bionicbone/Gasser_Monitor_v1/Documentation/Temperature Tx Telemetry Setup.jpg

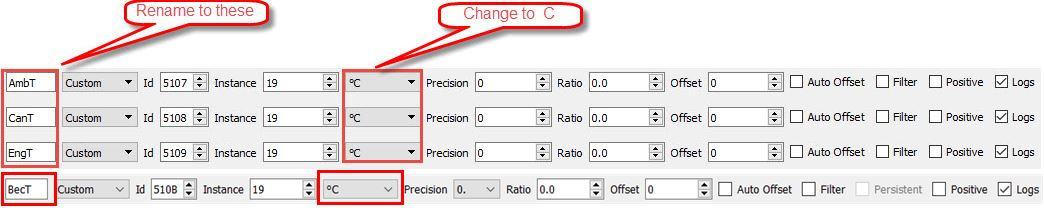
Documentation/Temperature Tx Telemetry Setup.jpg
