bionicbone/Gasser_Monitor_v1/Documentation/Cheep 5v BEC.jpg

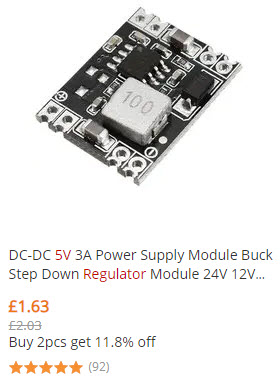
Documentation/Cheep 5v BEC.jpg
