bionicbone/Gasser_Monitor_v1/Documentation/LQ BFP Methodology.jpg

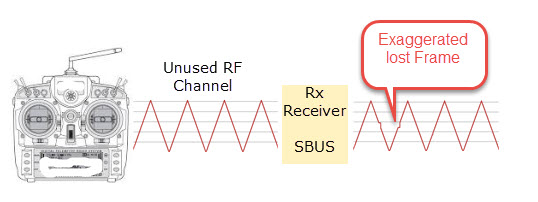
Documentation/LQ BFP Methodology.jpg
