bionicbone/Gasser_Monitor_v1/Documentation/LQ Hold 16ch 2 Wave Calculation on ch1-8.jpg

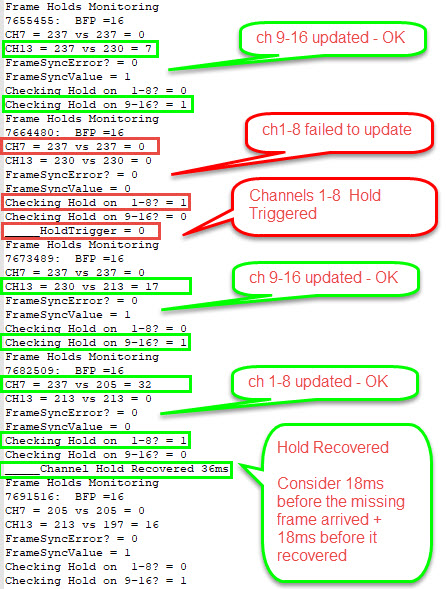
Documentation/LQ Hold 16ch 2 Wave Calculation on ch1-8.jpg
