bionicbone/Gasser_Monitor_v1/Documentation/LQ Hold 16ch 2 Wave Chart.jpg

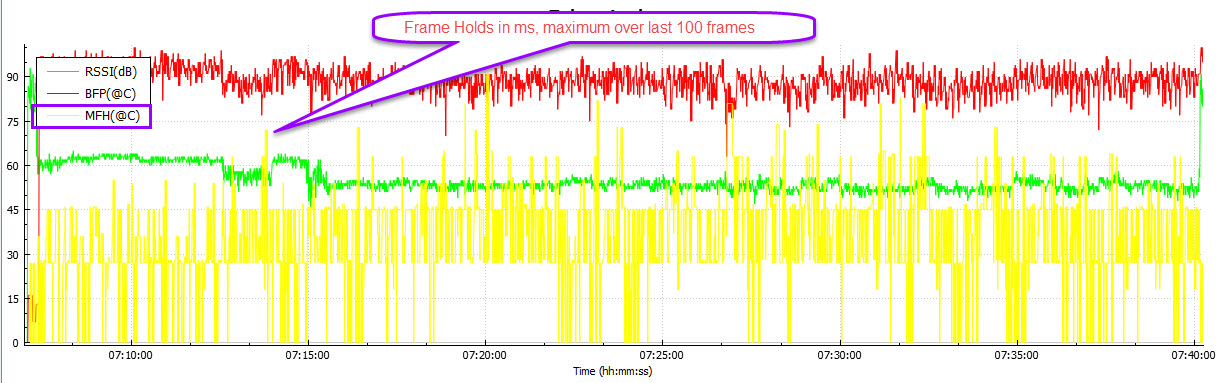
Documentation/LQ Hold 16ch 2 Wave Chart.jpg
