bionicbone/Gasser_Monitor_v1/Documentation/LQ LFP on v2.1.0 firmware.jpg

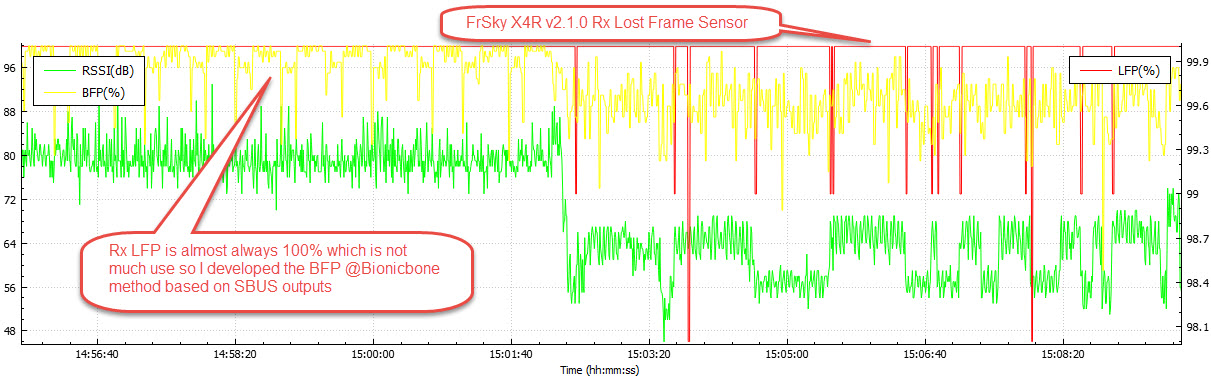
Documentation/LQ LFP on v2.1.0 firmware.jpg
