bionicbone/Gasser_Monitor_v1/Documentation/LQ Sync16ch 2 Wave Success.jpg

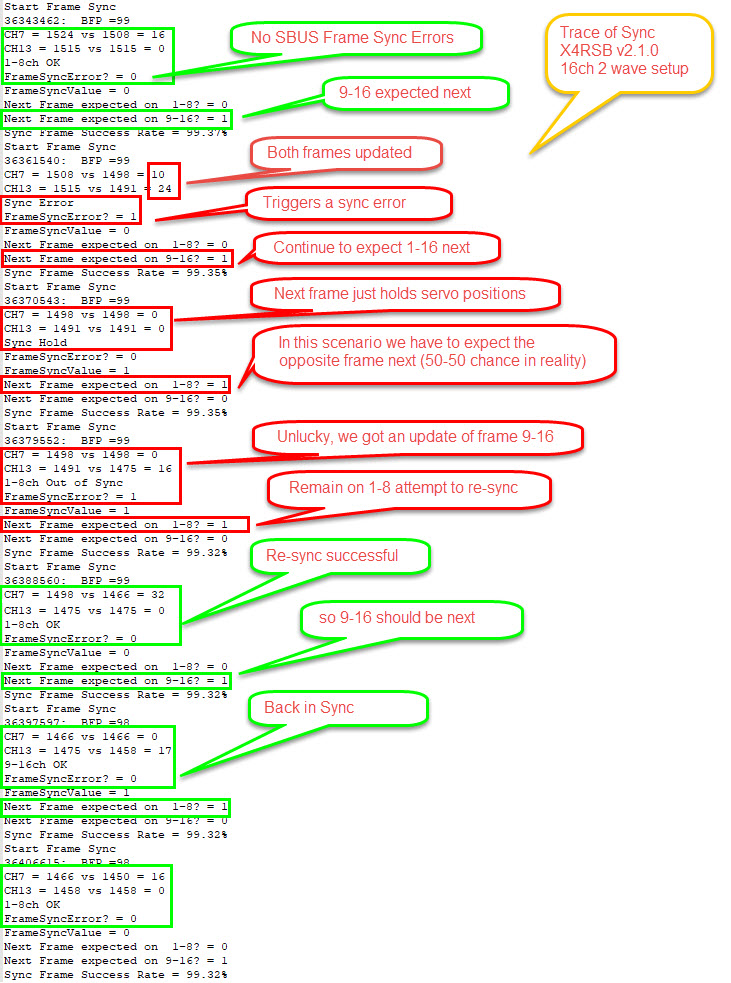
Documentation/LQ Sync16ch 2 Wave Success.jpg
