bionicbone/Gasser_Monitor_v1/Documentation/OLED Flight Battery Voltage.jpg

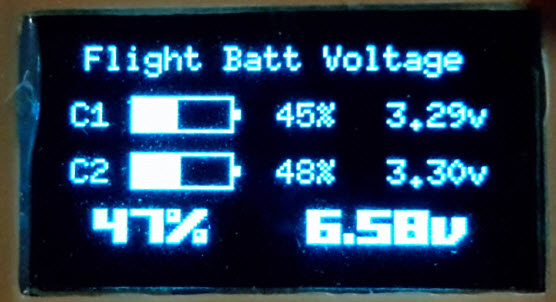
Documentation/OLED Flight Battery Voltage.jpg
