bionicbone/Gasser_Monitor_v1/Documentation/Power Charging Circuit.jpg

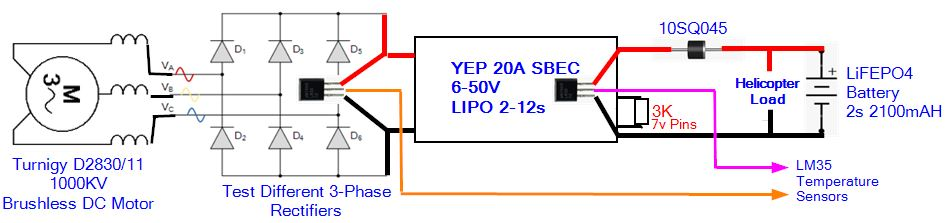
Documentation/Power Charging Circuit.jpg
