bionicbone/Gasser_Monitor_v1/Documentation/Power Modules.jpg

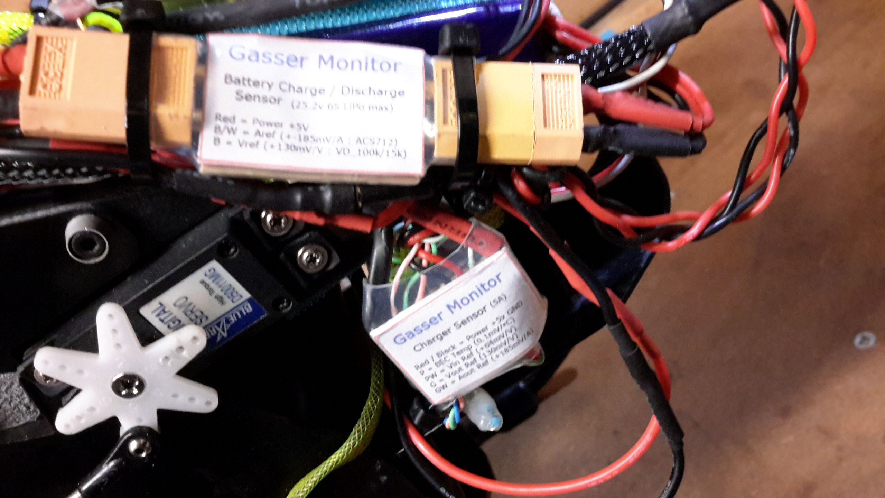
Documentation/Power Modules.jpg
