bionicbone/Gasser_Monitor_v1/Documentation/Power Rectifier Pic 1.jpg

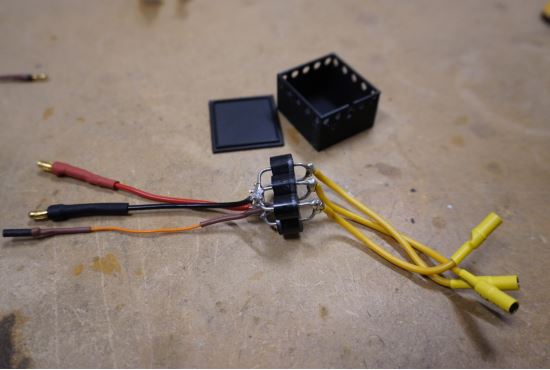
Documentation/Power Rectifier Pic 1.jpg
