bionicbone/Gasser_Monitor_v1/Documentation/Power Rectifier Pic 2.jpg

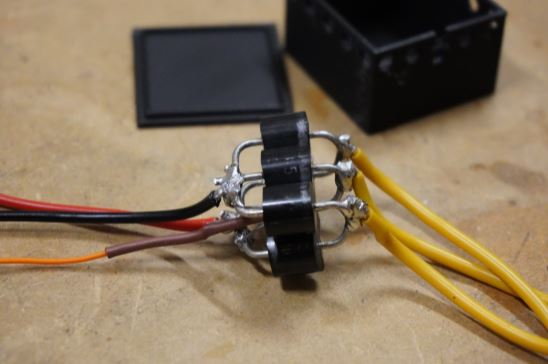
Documentation/Power Rectifier Pic 2.jpg
