bionicbone/Gasser_Monitor_v1/Documentation/Power Rectifier Pic 3.jpg

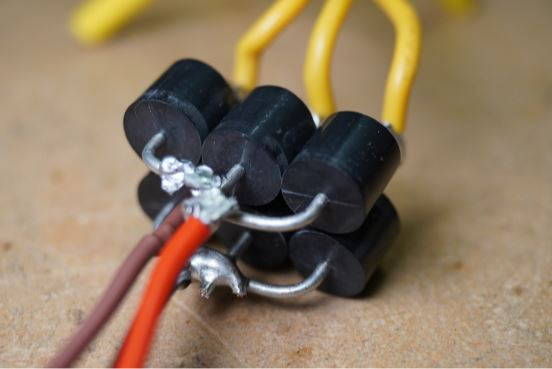
Documentation/Power Rectifier Pic 3.jpg
