bionicbone/Gasser_Monitor_v1/Documentation/Power Rectifier Pic 4.jpg

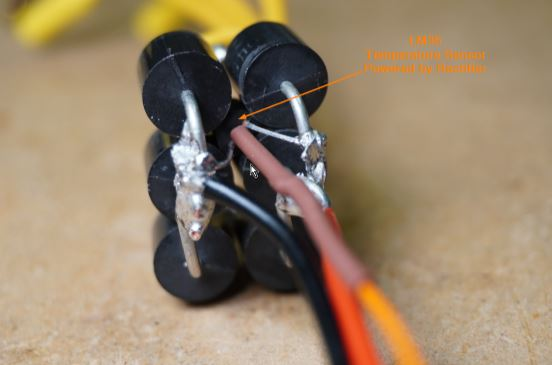
Documentation/Power Rectifier Pic 4.jpg
