bionicbone/Gasser_Monitor_v1/Documentation/Power Rectifier Pic 5.jpg

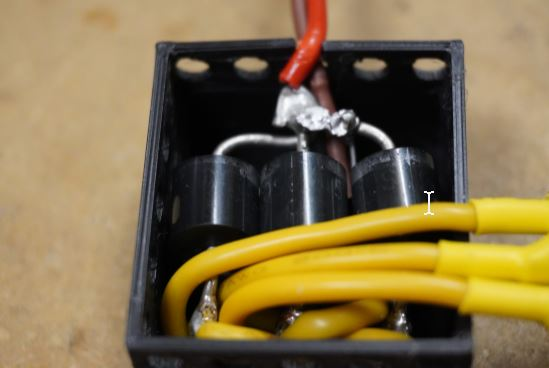
Documentation/Power Rectifier Pic 5.jpg
