bionicbone/Gasser_Monitor_v1/Documentation/Power Sensors Analysis.jpg

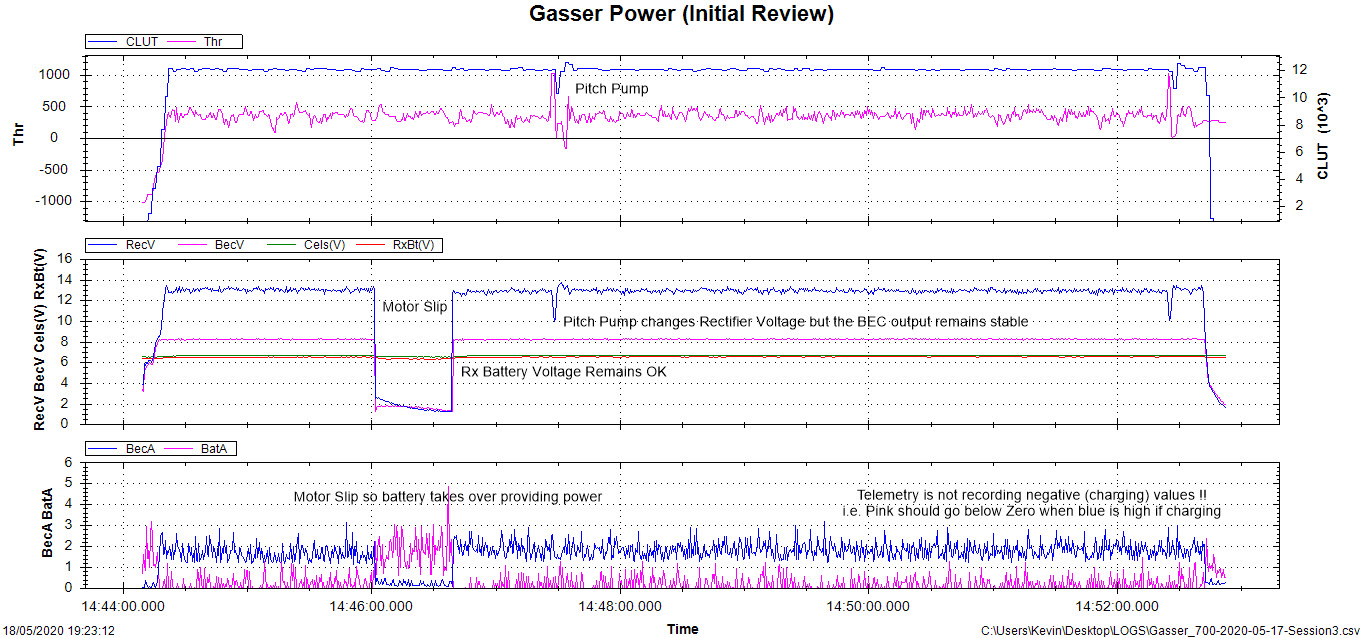
Documentation/Power Sensors Analysis.jpg
