bionicbone/Gasser_Monitor_v1/Documentation/RPM Charging Dog Sensor.jpg

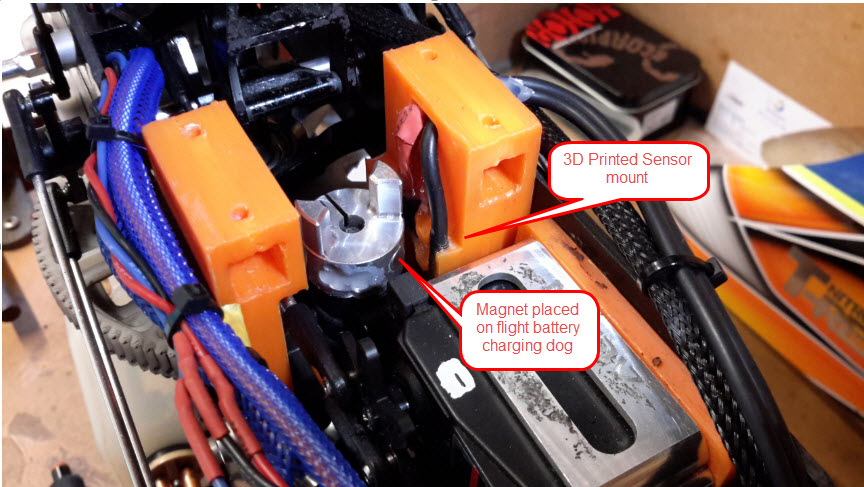
Documentation/RPM Charging Dog Sensor.jpg
