bionicbone/Gasser_Monitor_v1/Documentation/RPM Clutch Analysis.jpg

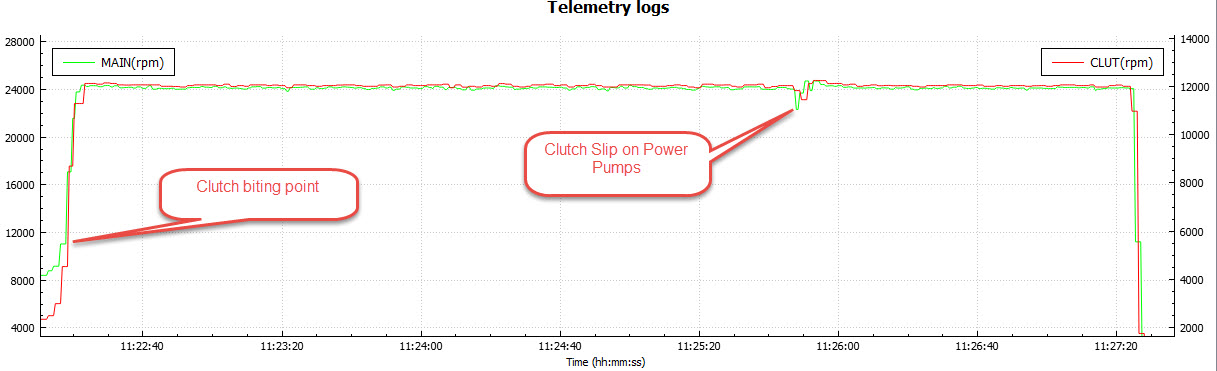
Documentation/RPM Clutch Analysis.jpg
