bionicbone/Gasser_Monitor_v1/Documentation/RPM Clutch Sensor.jpg

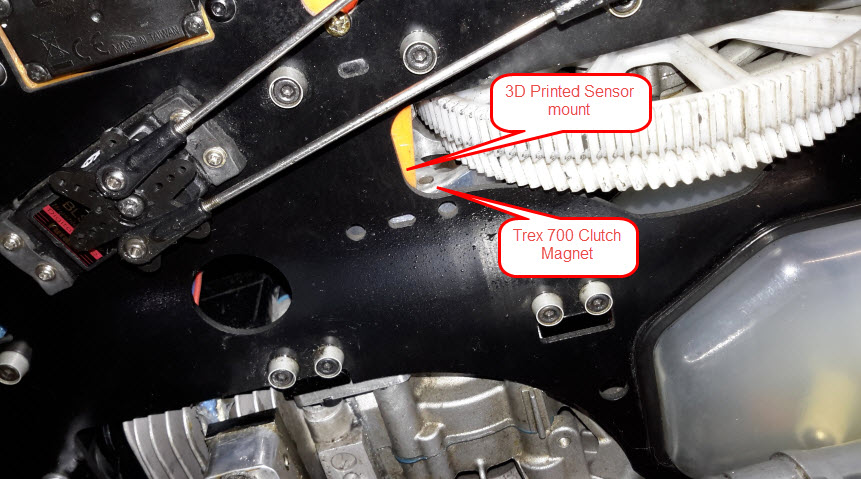
Documentation/RPM Clutch Sensor.jpg
