bionicbone/Gasser_Monitor_v1/Documentation/RPM Sensor Connections.jpg

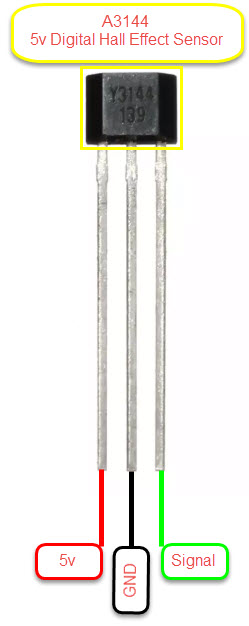
Documentation/RPM Sensor Connections.jpg
