bionicbone/Gasser_Monitor_v1/Documentation/RPM Sensor Fitting with Magnets.jpg

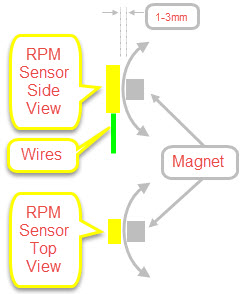
Documentation/RPM Sensor Fitting with Magnets.jpg
