bionicbone/Gasser_Monitor_v1/Documentation/SD BFP MCHM Chart.jpg

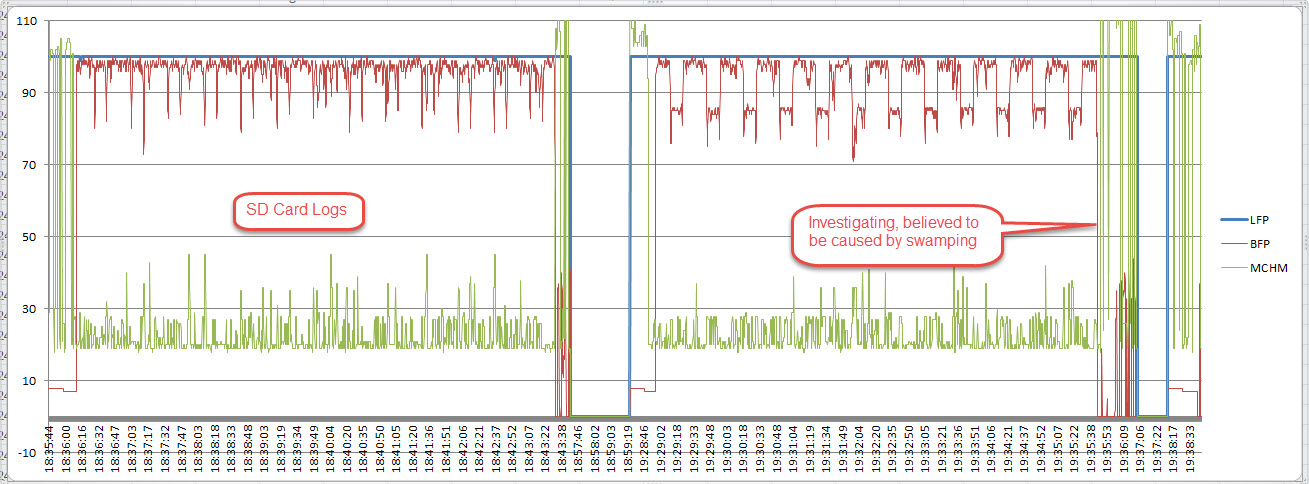
Documentation/SD BFP MCHM Chart.jpg
