bionicbone/Gasser_Monitor_v1/Documentation/SD Connection Picture.jpg

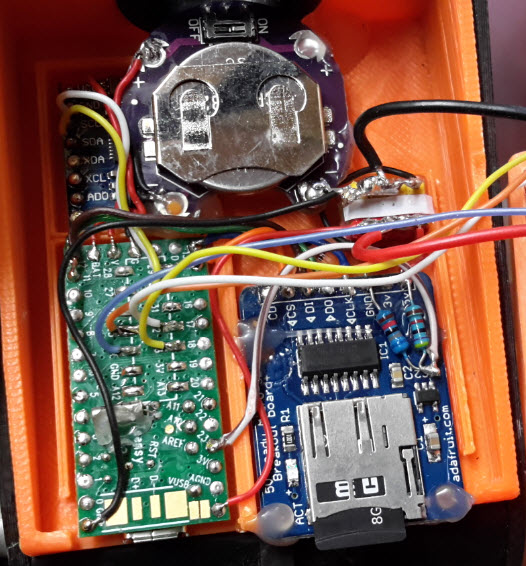
Documentation/SD Connection Picture.jpg
