bionicbone/Gasser_Monitor_v1/Documentation/SD Connections.jpg

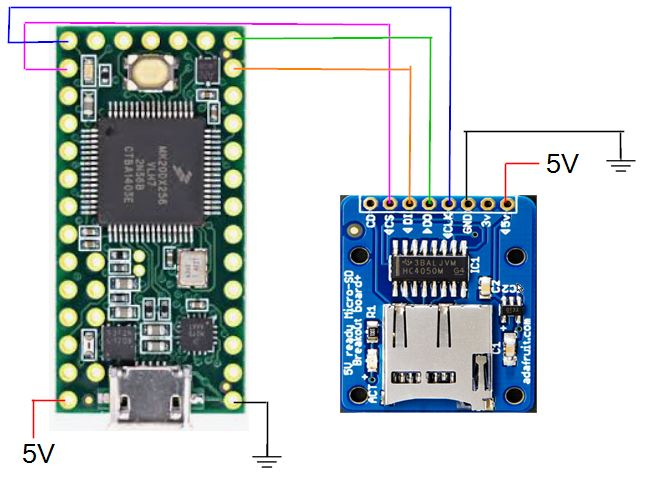
Documentation/SD Connections.jpg
