bionicbone/Gasser_Monitor_v1/Documentation/Sticker Battery Charge Discharge.jpg

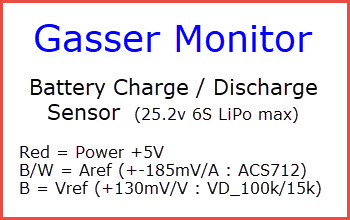
Documentation/Sticker Battery Charge Discharge.jpg
