bionicbone/Gasser_Monitor_v1/Documentation/Sticker BEC Charger Sensor.jpg

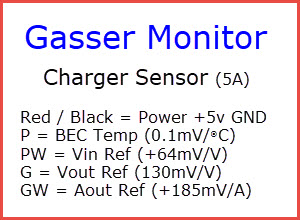
Documentation/Sticker BEC Charger Sensor.jpg
