bionicbone/Gasser_Monitor_v1/Documentation/Teensy FLVSS MLVSS connections.jpg

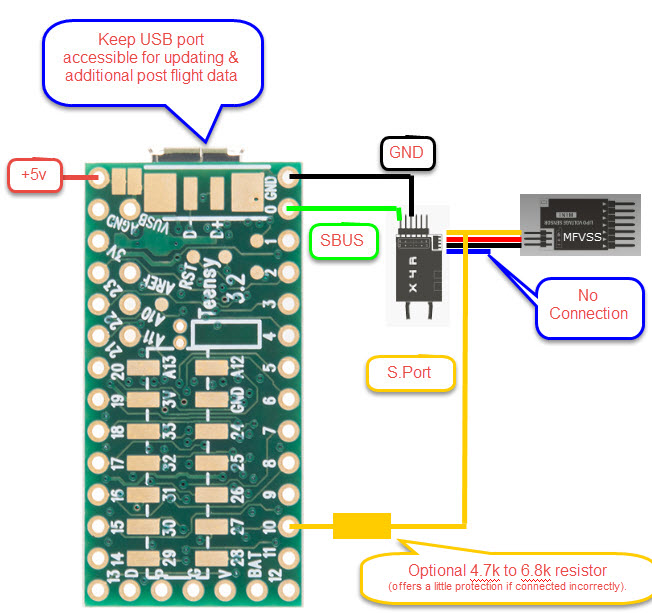
Documentation/Teensy FLVSS MLVSS connections.jpg
