bionicbone/Gasser_Monitor_v1/Documentation/Teensy LM35 Temperature Connections.jpg

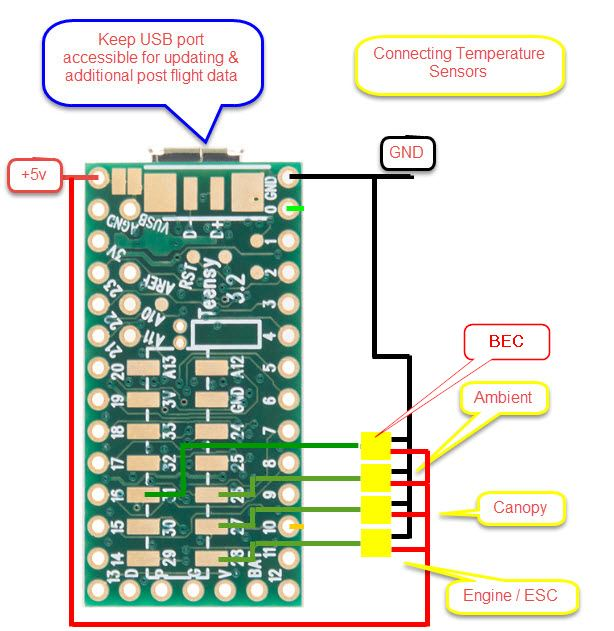
Documentation/Teensy LM35 Temperature Connections.jpg
