bionicbone/Gasser_Monitor_v1/Documentation/Teensy Power Cut Track.jpg

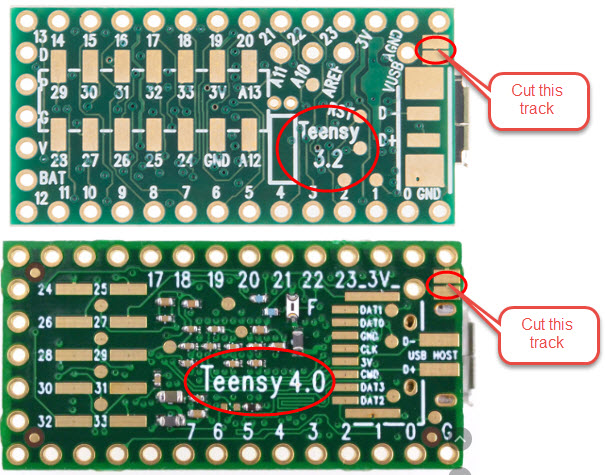
Documentation/Teensy Power Cut Track.jpg
