bionicbone/Gasser_Monitor_v1/Documentation/Teensy Power SBUS SPORT connections.jpg

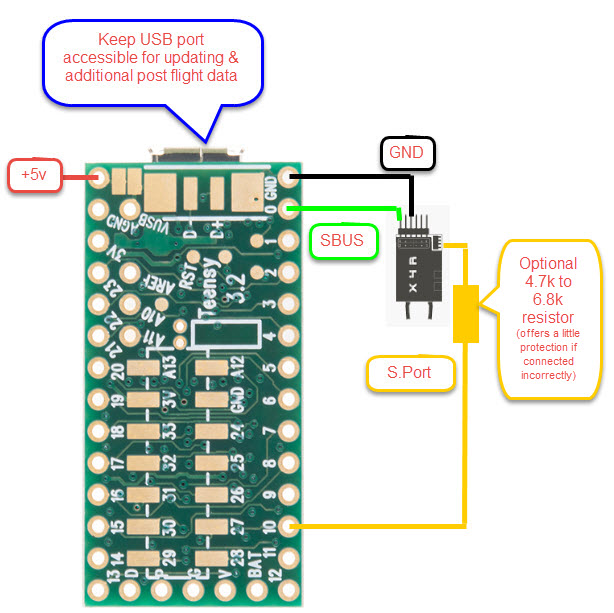
Documentation/Teensy Power SBUS SPORT connections.jpg
