bionicbone/Gasser_Monitor_v1/Documentation/Teensy RPM Connections.jpg

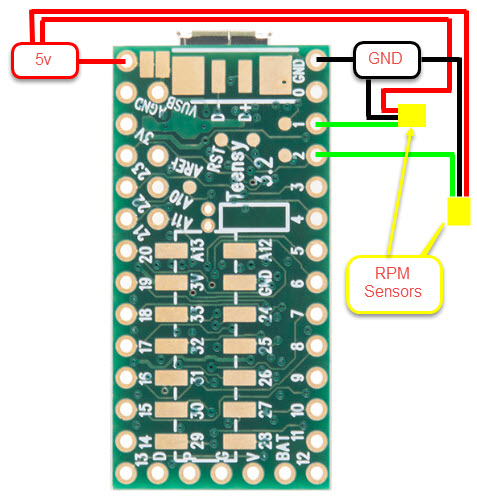
Documentation/Teensy RPM Connections.jpg
