bionicbone/Gasser_Monitor_v1/Documentation/Temperature BEC with Canopy On.jpg

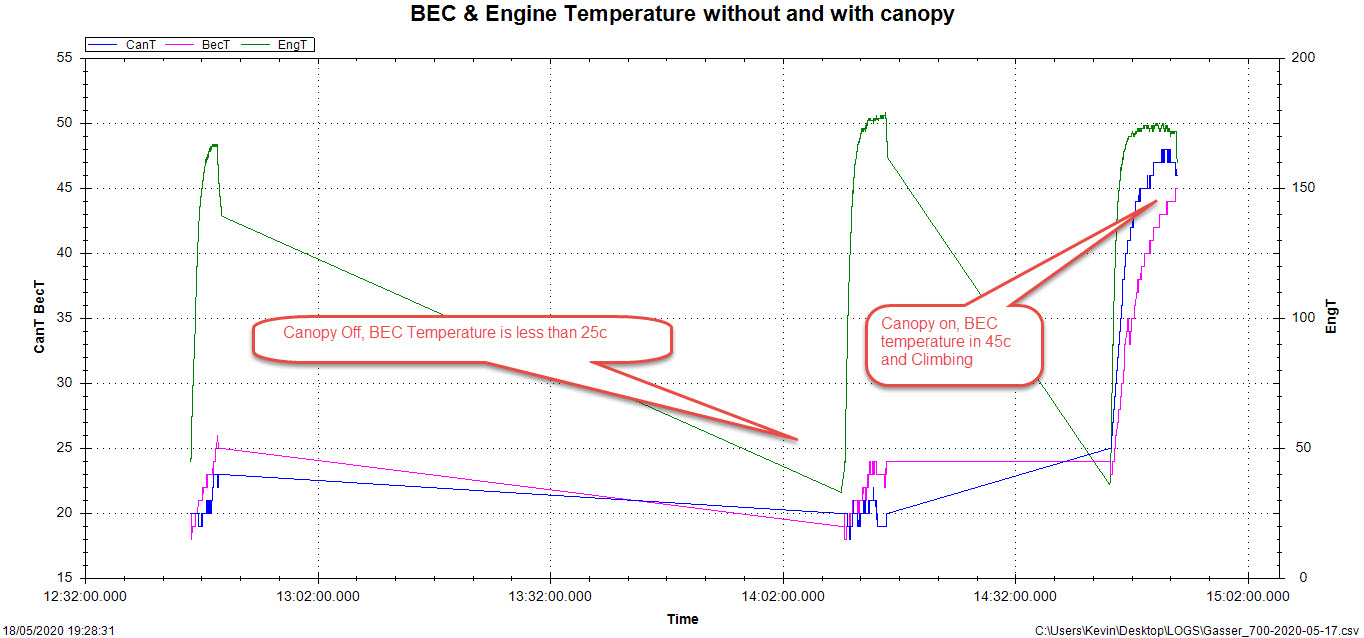
Documentation/Temperature BEC with Canopy On.jpg
