bionicbone/Gasser_Monitor_v1/Documentation/Temperature Engine LM35 Sensor Placement.jpg

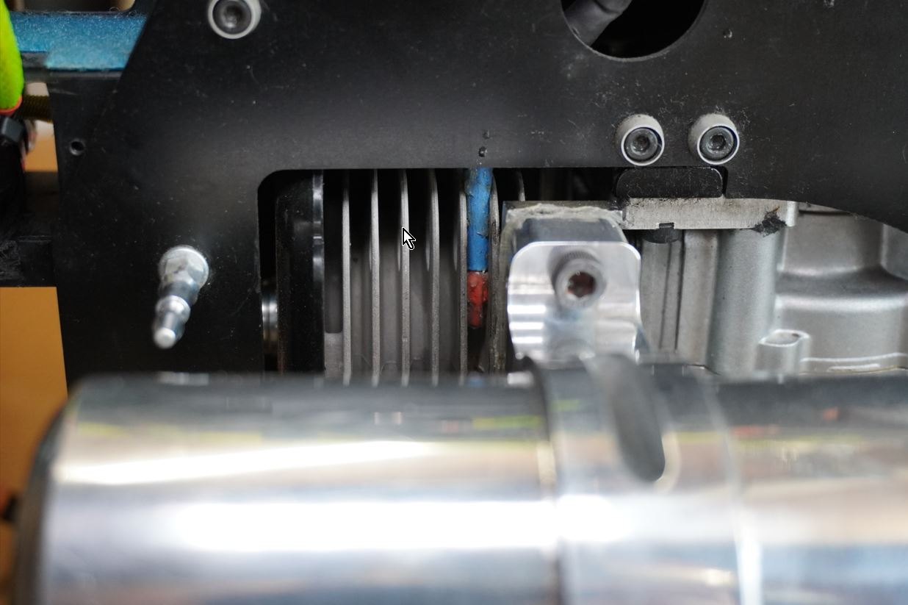
Documentation/Temperature Engine LM35 Sensor Placement.jpg
