bionicbone/Gasser_Monitor_v1/Documentation/Temperature Sensor Analysis.jpg

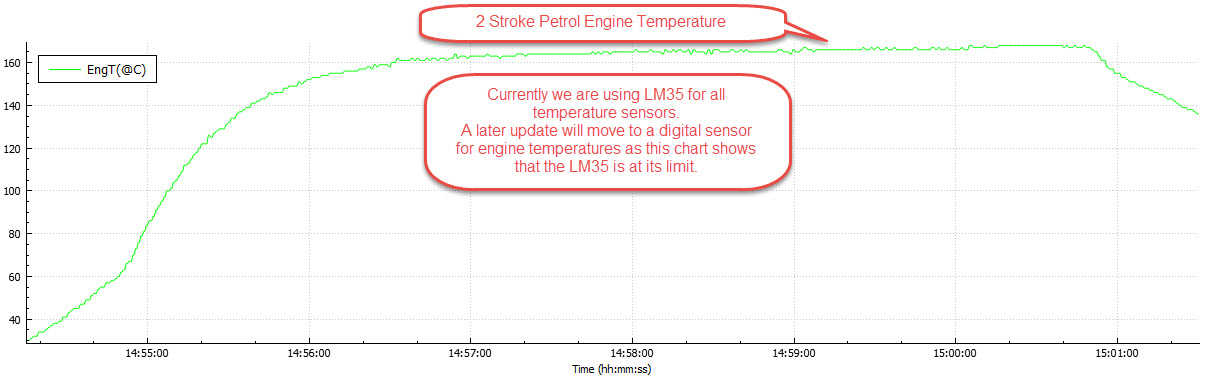
Documentation/Temperature Sensor Analysis.jpg
