bionicbone/Gasser_Monitor_v1/Documentation/Temperature Sensor Connections.jpg

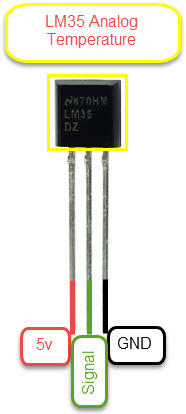
Documentation/Temperature Sensor Connections.jpg
