bionicbone/Gasser_Monitor_v1/Documentation/LQ Tx Wave Setup Channel Check.jpg

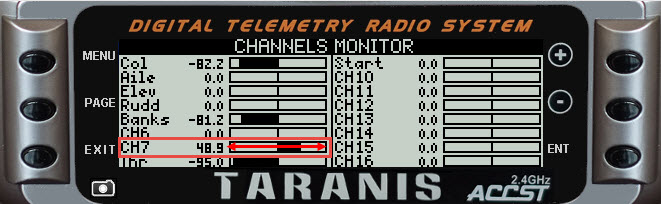
Documentation/LQ Tx Wave Setup Channel Check.jpg
