bionicbone/Gasser_Monitor_v1/Documentation/LQ Tx Wave Setup Mix Copy.jpg

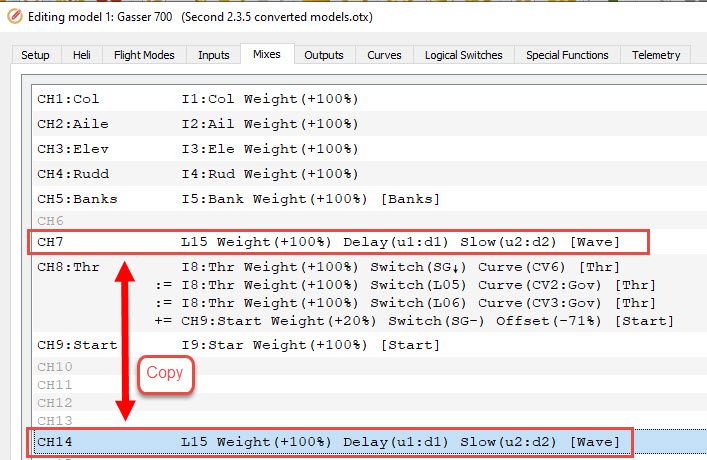
Documentation/LQ Tx Wave Setup Mix Copy.jpg
