bionicbone/Gasser_Monitor_v1/Documentation/OLED Wiring Picture.jpg

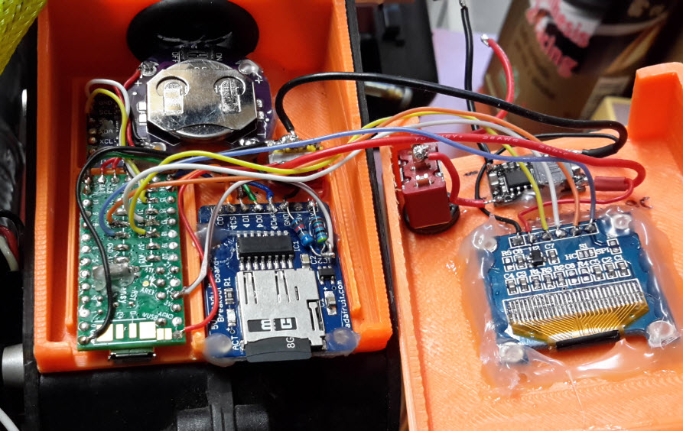
Documentation/OLED Wiring Picture.jpg
