bionicbone/Gasser_Monitor_v1/Documentation/OLED Wiring.jpg

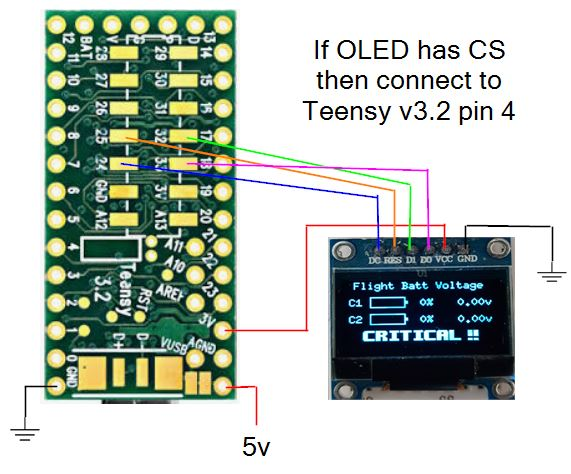
Documentation/OLED Wiring.jpg
