bionicbone/Gasser_Monitor_v1/Documentation/RPM 3D Printed Mount.jpg

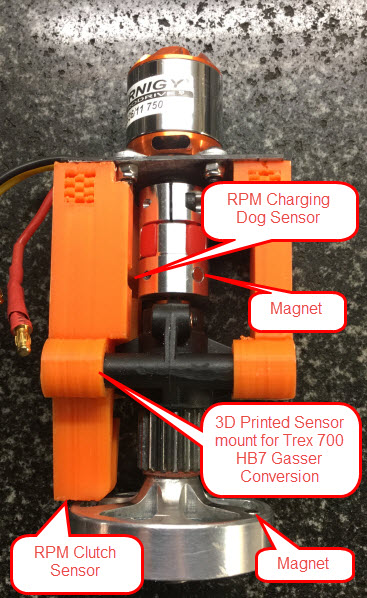
Documentation/RPM 3D Printed Mount.jpg
