bionicbone/Gasser_Monitor_v1/Documentation/LQ BFP in all channel modes-Test2.jpg

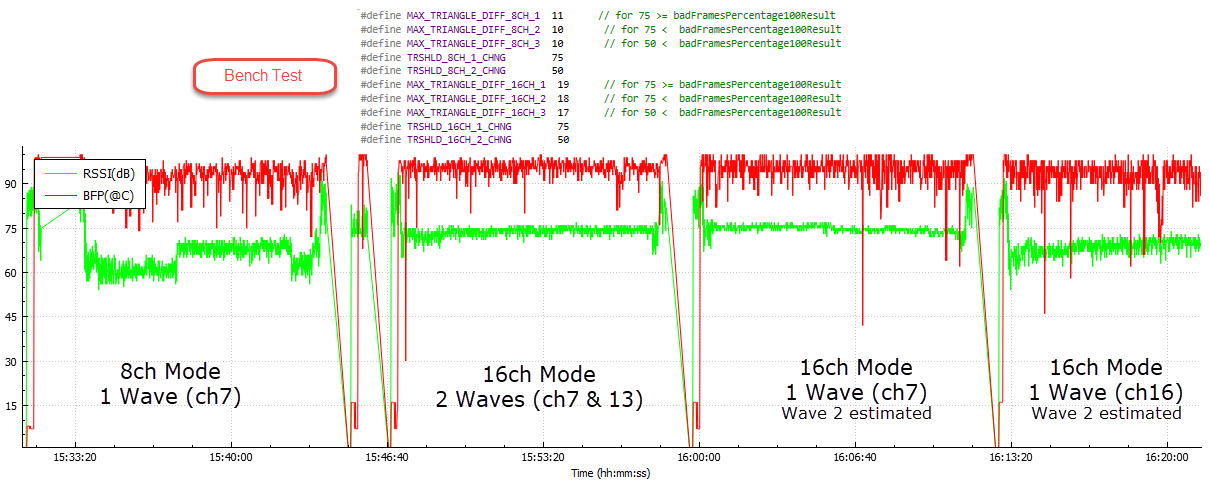
Documentation/LQ BFP in all channel modes-Test2.jpg
