bionicbone/Gasser_Monitor_v1/Documentation/LQ BFP in all channel modes-Test3.jpg

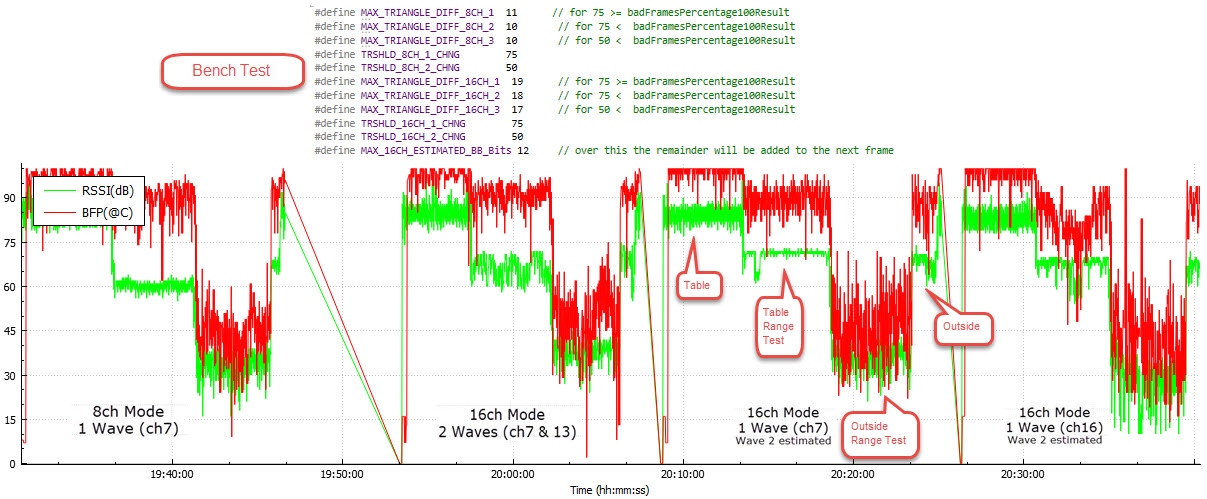
Documentation/LQ BFP in all channel modes-Test3.jpg
