bionicbone/Gasser_Monitor_v1/Documentation/Vibration Acc Results.jpg

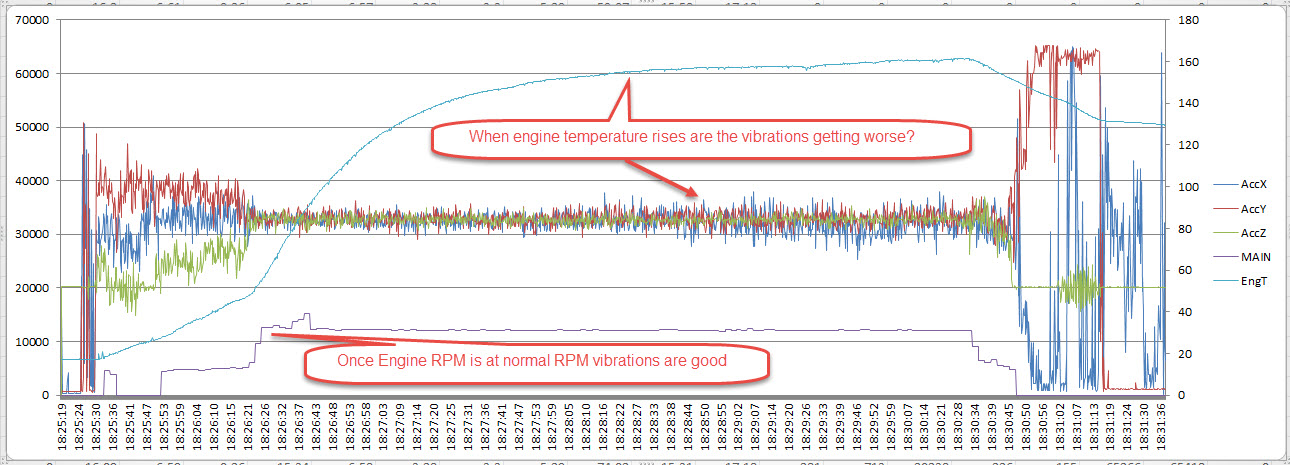
Documentation/Vibration Acc Results.jpg
