bionicbone/Gasser_Monitor_v1/Documentation/MLVSS FLVSS Low Power Issue 2.jpg

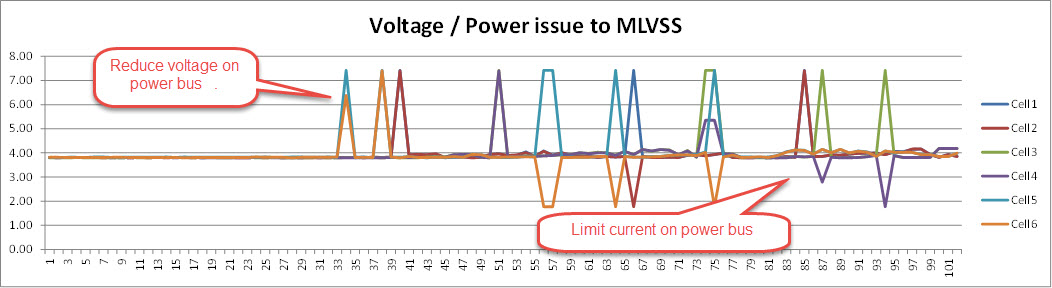
Documentation/MLVSS FLVSS Low Power Issue 2.jpg
