bionicbone/Gasser_Monitor_v1/(commit log)

2020-03-15 RPM Initial Upload
    First upload for the RPM code migrated from the Gasser Charger v2 code.
    Tested using code within code but not live at the time of this commit.
2020-03-15 RxLinkQuality Initial Upload
    First upload for the RxLinkQuality code migrated from the Gasser Charger v2 code.
    Not Tested at all until Telemtery is enabled
    //TODO - Add FailSafe Counter
    //TODO - Add the Maximum Channels Held over last 100 frames
    //TODO - Add the Min / Max SBUS Refresh Rates over last 100 frames
    [Gasser_Monitor_v1.ino, RxLinkQuality.cpp, RxLinkQuality.h]
2020-03-16 Telemetry Initial Upload
    First upload for the Telemetry code migrated from the Gasser Charger v2 code.
    Not Tested until the main loop is completed
    // TODO - Activate cell1 and cell2 and remove temporary variable declarations below
    // TODO - Activate enginTemp and remove temporary variable declaration below
    // TODO - Activate error and error1 and remove temporary variable declarations below
    // TODO - Activate reg and bec and remove temporary variable declarations below
    // TODO - Tidy code and check comments
    [Gasser_Monitor_v1.ino, RxLinkQuality.cpp, RxLinkQuality.h, Telemetry.cpp, Telemetry.h]
2020-03-16 Add time limit to find_WaveChannel()
    If there is no FrSky Rx attached then this process can become stuck in an endless loop trying to find an valid SBUS signal.
    Tested without Rx Attached
    //TODO - Confirm that MAX_WAIT_TIME_MS = 5000 is not too short or too long when receiver is attached.
    [Gasser_Monitor_v1.ino, RxLinkQuality.cpp, RxLinkQuality.h]
2020-03-17 Add Rescan for Wave Channel if not found
    Do rescan for Wave Channel if not found on initilisation
    Normal scan time is 180ms, max 300ms. Reduce MAX_WAIT_TIME_MS to 200ms
    On serial debug data +1 on the channel found to align with Tx
    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
    [Gasser_Monitor_v1.ino, RxLinkQuality.cpp]
2020-03-23 Bug Fix
    #defined DEBUG_DATA needed to be in a Config.h file.
    Other small changes
    [Config.h, Gasser_Monitor_v1.ino, RxLinkQuality.cpp, RxLinkQuality.h, Telemetry.cpp]
2020-03-27 Add find_WaveChannel_New
    Add find_WaveChannel_New which now looks for waves between ch1-8 and ch9-16. It also works out if the Tx/Rx are in 8ch or 16ch mode.
    Add FailSafe code, with overall failsafe counter
    [Config.h, Gasser_Monitor_v1.ino, RxLinkQuality.cpp, RxLinkQuality.h, Telemetry.cpp]
2020-03-29 Calibrated ready for testing
2020-03-30 Add failSafe check to LQ BFP
    [RxLinkQuality.cpp, RxLinkQuality.h]
2020-04-04 Fix Hold Time
    Needed to add the time before the hold was discovered
    Update 16ch 2 Wave Hold Picture
    [Config.h, RxLinkQuality.cpp]
2020-04-05 Fix 10th Frame Skip
    [RxLinkQuality.cpp]
2020-04-05 Align Hold Array 0=frame 1, 1=frame 2
2020-04-05 Fix Ch8 Mode BFP
    This bug was introduced by adding ability to have 16ch mode
    [RxLinkQuality.cpp]
2020-04-06 One MFH value for 16ch 2 wave
    channelsMaxHoldMillis100Result chenged to channelsMaxHoldMillis100Resul (note no t) because of some weird bug.
    Now just send over telemetry the worst maximum in 16ch 2 wave mode
    [RxLinkQuality.cpp, RxLinkQuality.h, Telemetry.cpp]
2020-04-06 Add Initial SBUS Frame Rate Monitoring
2020-04-07 Add SBUS Frame Rates
2020-04-09 Change LQRX #warnings to #errors
    [Config.h, RxLinkQuality.cpp]
2020-04-09 Add firstRun to inhibit initial errors
    [Config.h, Gasser_Monitor_v1.ino, RxLinkQuality.cpp, RxLinkQuality.h]
2020-04-10 SBUS Frame Rate Perfection
2020-04-10 Add End to End Rx Tx SBUS Quality Indicator
    A calculation that includes lostFrames%, BadFrames%, Ch16%, SbusFrameRate, ChMaxHold and failSafe to give 0-100 quality indicator
    [Config.h, RxLinkQuality.cpp, RxLinkQuality.h, Telemetry.cpp]
2020-04-10 Create LQ SBUS Frame Rates.jpg
2020-04-10 Create LQ End to End SBUS Frame Rate.jpg
2020-04-10 Create LQ End to End Frame Holds.jpg
2020-04-11 Add temperature sensors
    Ambient, Canopy and Engine / ESC LM35 sensor code added
    Sent via Telemetry
2020-04-11 Create Temperature Tx Telemetry Setup.jpg
2020-04-11 Create Temperature Sensor Connections.jpg
2020-04-11 Create Temperature Sensor Analysis.jpg
2020-04-11 Create Teensy LM35 Temperature Connections.jpg
2020-04-17 New Telemetry Code
    Remove Pawelsky Telemetry Code
    Initial upload of new method of sending telemetry.
    Uses SensorID 19 for all values for easy changing is FrSky assign to something else.
    Allows for up to 32 DataID's (in FrSkyDIY data range), 24ms refresh rate per value added.
    Still needs timing code, on this version it just updates the next value (if data changed) in sequence on each request.
    If all 32 DataID's are active then this can create a refresh rate of 768ms hence timing code needed
2020-04-17 Push Sensor Descriptions into code
2020-04-17 Ensure number comparisions are correct
    Also add new Telemetry Setup Pictures
    [Telemetry.cpp]
2020-04-17 Move nextSensorNumber determination to correct place
    [Telemetry.cpp]
2020-04-18 Add FLVSS Decoding
    Allows decoding of an attached FrSky FLVSS module every 708ms
    Also done a code tidy
2020-04-18 Initial Power Code Added
    The Current measurements should be OK.
    Voltages need work as I spent a long time messing with Cell Voltages which I now capture using MLVSS module.
2020-04-19 Initial Upload
    Most of code it commented out due to issues, needs to be implemented correctly,
    Only really added at this stage becasue I need to "Warning Leds" for testing the Power Charigng Code.
    [ErrorHandling.cpp, ErrorHandling.h, Gasser_Monitor_v1.ino]
2020-04-19 Error Handling
    Add ErrorHandling Setup process
    Add Error LED controller
    [ErrorHandling.cpp, ErrorHandling.h, Gasser_Monitor_v1.ino]
2020-04-25 Calibarate ASC714 Sensor Values
    Calibarate ASC714 Sensor Values
2020-04-25 Track code changes
2020-04-25 Discharge Working
    Stabilise and Discharge (mah) is working now.
    [Gasser_Monitor_v1.ino]
2020-04-26 Calibrate Voltages
2020-05-16 Charging Tests
    During this part I had to do several changes. Therefore I'm going to push them all to the main project and then alter the main .ino back to what I want it to run.
    One main change was now both Hall Effect Sensor for current monitoring now use the ASC712 codes, the other should be deteled as they may not be correct.
    [Config.h, Gasser_Monitor_v1.ino, Power.cpp, Power.h]
2020-05-16 First commit before initial test on gasser
    Change some varibale names
    Alter #warning to #error
    Remove calls the Charge Testing
    Comment out ACS713/4 codes
    [Config.h, Gasser_Monitor_v1.ino, Power.cpp, Power.h]
2020-05-18 Add BEC Temperature
2020-05-18 Fix Double RPM from the Flywheel
    [RPM.cpp]
2020-05-23 Calibration and Telemetry Corrections
    Bidirectional Battery Current Flow Calibrated on Gasser
    Unidirctional BEC Current Flow Calibrated on Gasser
    Voltages Calibrated on Gasser
    Telemery Values now Transmit Correctly
    [Gasser_Monitor_v1.ino, Power.cpp, Telemetry.cpp]
2020-05-24 Temperature - constexpr auto instead of #define in .h files
    constexpr auto instead of #define in .h files
2020-05-24 Power - constexpr auto instead of #define in .h files
    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
2020-05-24 ErrorHandling - constexpr auto instead of #define in .h files
    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
    [ErrorHandling.h]
2020-05-24 Flashed Clean Build to Gasser
    Power feeds calibrated
    Some code cleaning, global / pubic variables / functions prefixed with _
    Looking good on the Tx Telemetry
    Next major step planned is to add the SD Card logging
2020-05-25 Initial SD Card Log Timer
    Need to test on Gasser to see if telemetry and everything else still works
2020-05-25 Stop hang if SD Card fails to initilise
    [SdCard.cpp]
2020-06-01 Add Battery Voltage
    Works regardless of CELS module
2020-06-19 Initial OLED code
    At the moment it only displays 2 x CELL voltages with Battery Graphic and CRITICAL warnings etc.
    Much more development to be done here.
2020-06-20 Test Code - Battery Cell Display
    Add some Test Code for the Battery Cell Display, this is commented out normally
2020-06-21 Initial MCU Vibration Code
    Still need to look at main loop timings
    [Config.h, Gasser_Monitor_v1.ino, MCU6050.cpp, MCU6050.h, OLED.h, SdCard.cpp]
2020-06-28 Add OLED Device Name and Date Time on Boot Up
    The start up takes quite awhile to get initial values so this give something for the display to show during boot up.
    Eventually it will display the last error message that occurred during the last flight during this time.
    [Config.h, Gasser_Monitor_v1.ino, OLED.cpp, OLED.h]
2020-06-28 Vibration public variables
    Make key variables public so they can be written to SD Card logs
    Also renamed the variables a little so they match the SD card log headers
    [MCU6050.cpp, MCU6050.h]
2020-06-28 Add vibration data to SD Card
    Add vibration data to SD Card
    [SdCard.cpp]
2020-08-21 Calibrate Voltages
    Voltages have been calibrated.
    Note and picture have also been taken and uploaded to the onenote info.
2020-08-29 Remove Frame Rate from E2EQ indicator
2020-08-29 Remove SBUS Frame Rate Completely from Code
    Remove SBUS Frame Rate Analysis
    Remove from SBUS logging
2020-08-29 Fix missing GyrZ from SD Card Logging
    Fix missing GyrZ from SD Card Logging
    [SdCard.cpp]
2020-08-30 Move BatA to permanent Telemetry value
    Move BatA to permanent Telemetry value
    Delete all Temp Telemetry values used for messing with power values
2020-08-30 First Draft at Error Handling
    [Config.h, ErrorHandling.cpp, ErrorHandling.h, Telemetry.cpp, Temperature.h]
2020-08-30 Fix SD Card Error Logging
    [SdCard.cpp]
2020-08-30 Add Array for Error Handling
    [ErrorHandling.cpp, Telemetry.cpp]
2020-08-30 Fix No Error Reset to Zero
    [ErrorHandling.cpp, ErrorHandling.h]
2020-09-17 Add Teensy 3.5 support as 3.2
    Added support to complie under Teensy 3.5.
    Assumption made that Teensy Single Wire control works using the same registers as Teensy 3.2.
2020-09-17 Calibrate BatV to CELS
    Calcualted this multiplier to give same result as CELS
2020-09-19 Initialise SD Card Correctly for Teensy v3.5
    Rick will test this on a V3.5
    [SdCard.cpp]
2020-09-19 Initialise the RPM interrupts correctly of the Teensy v3.5
    This will remain untested but its should work.
    [RPM.cpp]
2022-06-06 Recompile after a long break on this project Finding the correct SBUS library version was a nightmare, only compiles using v1.0.1 Other libraries I will have to hope they are still OK since many will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
    [Gasser_Monitor_v1.ino, MCU6050.cpp, MCU6050.h, RxLinkQuality.cpp]
2022-06-09 Add Logs Add Release
    [20200815 Battery in Low Charge State 3K0.CSV, 20200818 Battery Charged Before Flight 3K0.CSV, 20200824 Battery Charged Before Flight 1K2.CSV, 20200909.CSV, 20200913_1 Issues with SD Card is this really 20200830.CSV, 20200913_3 Issues with SD Card is this really 20200830.CSV, 20201018_2 Logged and its defo charging.CSV, 20220607.csv]
2024-04-08 Decided not to add PID to the main project and create a stand alone Gasser_Engine_BLDC_Motor program for the testing
2024-04-08 Revert "Merge pull request #75 from bionicbone/MotorPID"
    This reverts commit f497ce5e4a311624d46a03de2624d7ac8a7b5ddb, reversing
    changes made to 1646ad5bb866cc012ed9631f7e8677b6281958e7.
    [Gasser_Monitor_v1.ino]
2024-04-08 Documentation: Add Power Charging Circuit
2024-04-13 Add BEC Temperature Sensor as Telemtry Data, update documentation. Add picture on the LM35 sensor mounted on the engine
2024-04-19 Added debug for SD Card, RPM, Long Loops, Vibration. Fix Tx RPM issues Merged Main RPM and Clutch RPM averaging update into same if statement Added Head RPM (calculated from Clutch RPM), gear ratio s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
    [Config.h, Gasser_Monitor_v1.ino, MCU6050.cpp, RPM.cpp, RPM.h, SdCard.cpp, Telemetry.cpp]
2024-04-28 Remove /2 on Clutch RPM - I think it should be correct then
    [RPM.cpp]
